jrsikken/AEMBLINK/AEMBLINK R2 PCB.jpg

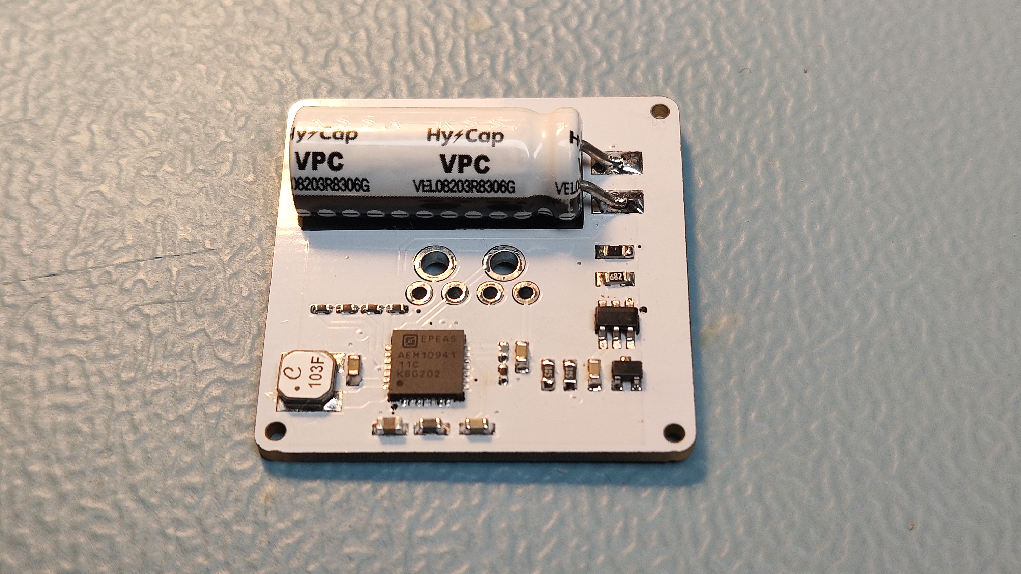
AEMBLINK R2 PCB.jpg
