jrsikken/AEMBLINK/AEMBLINK R2 in epoxy.jpg

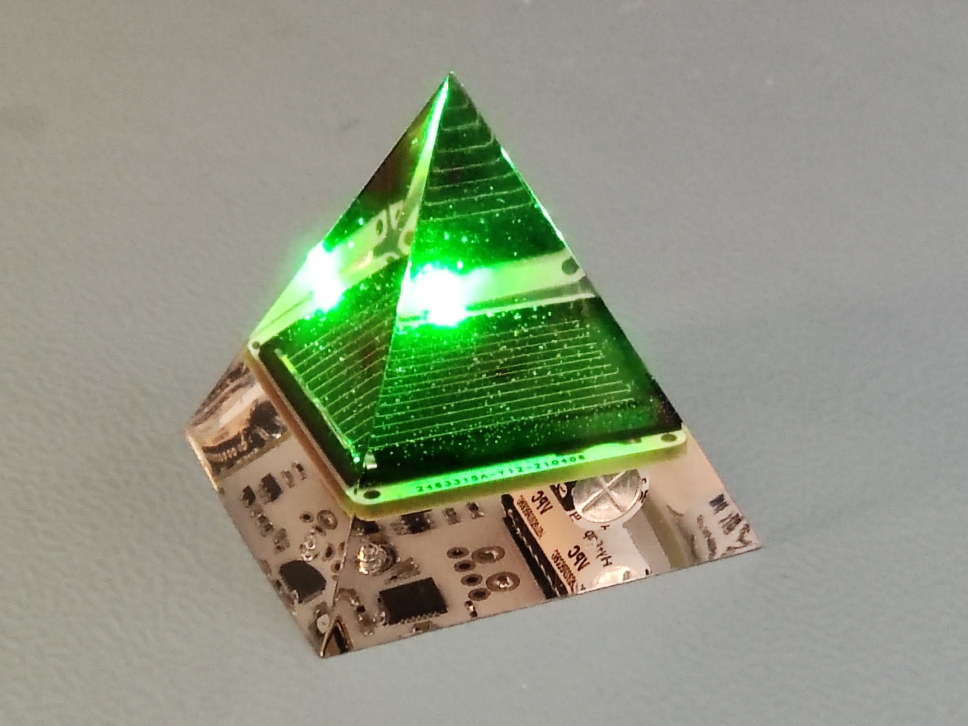
AEMBLINK R2 in epoxy.jpg
