jrsikken/AEMBLINK/README.md

# AEMBLINK
Design and production files for AEMBLINK, a solar harvesting LED blinking board

Eagle design files: *.sch and *.brd

Bill of Materials: *BOM.xlsx

Gerber files including stencil: *.gerber.zip

Schematic drawing: *SCHEMTAIC.png
