jrsikken/AEMBLINK/AEMBLINK-R1-SCHEMATIC.png

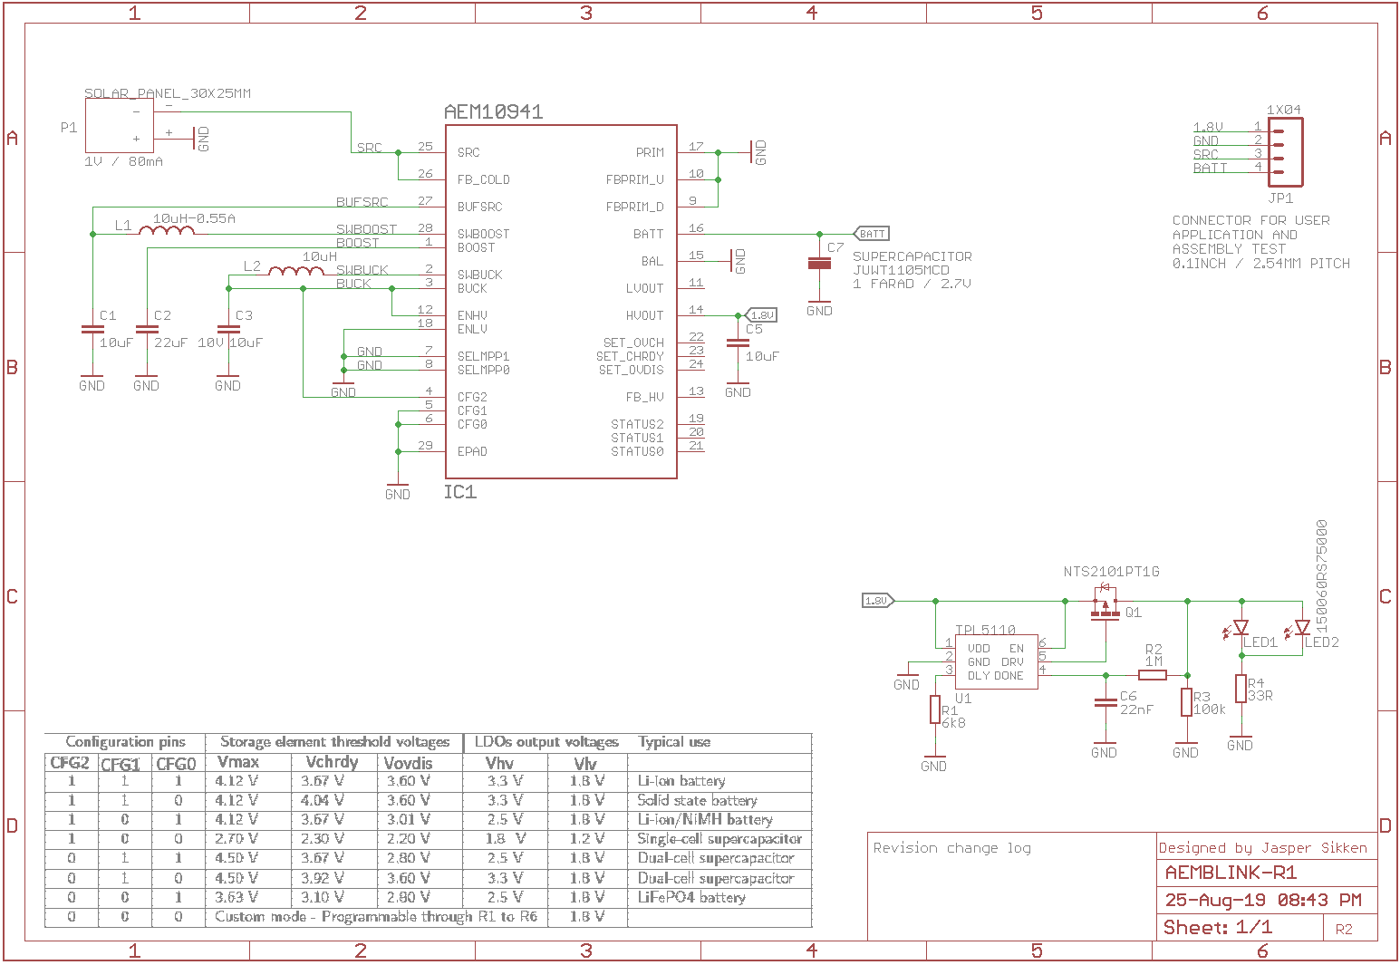
AEMBLINK-R1-SCHEMATIC.png
