jrsikken/AEMBLINK/AEMBLINK-R2-SCHEMATIC.png

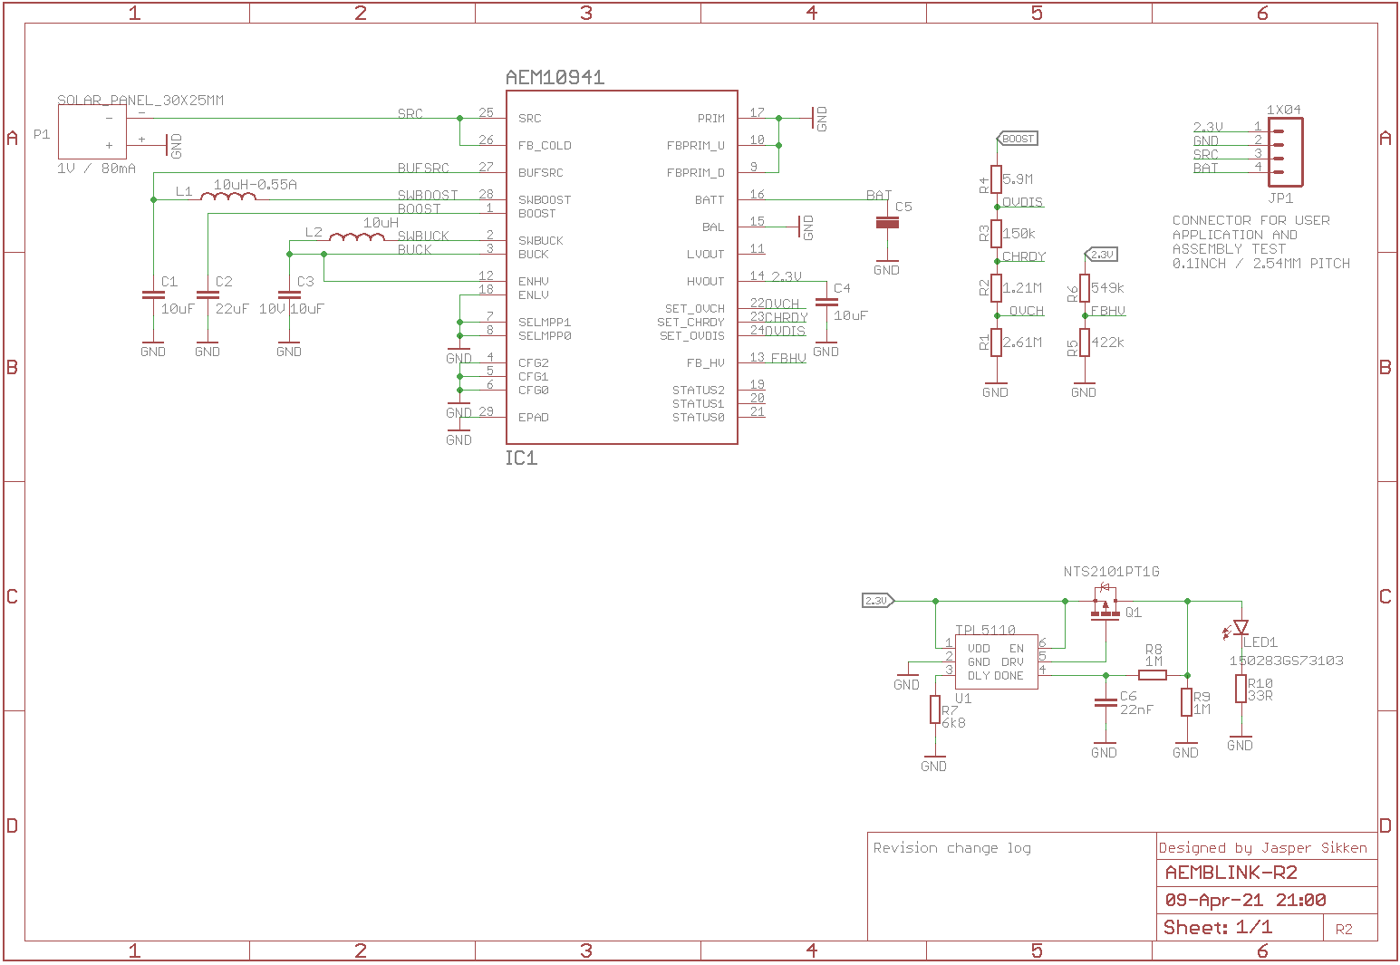
AEMBLINK-R2-SCHEMATIC.png
