jrsikken/AEMBLINK/AEMBLINK-R2-BOM.xlsx

# | reference designator | qty | value | package | Manufacturer | MPN | description | SMD | THT | PCB side | original | Voltage/Current | Dielectric | Tolerance
1 | C1,C3,C4 | 3 | 10uF | C0603 | Generic part | Generic part | capacitor | 6 |  | top | n | 10V | X5R | 0.2
2 | C2 | 1 | 22uF | C0603 | Generic part | Generic part | capacitor | 2 |  | top | n | 10V | X5R | 0.2
4 | C6 | 1 | 22nF | C0603 | Generic part | Generic part | capacitor | 2 |  | top | n | 25V | X7R | 0.1
5 | IC1 | 1 | AEM10941 | QFN50P505X50 | E-peas | AEM10941 | IC | 29 |  | top | y
6 | L1 | 1 | 10uH-0.55A | LPS4012 | COILCRAFT | LPS4012-103MRB | inductor | 2 |  | top | y
7 | L2 | 1 | 10uH-0.25A | L0603 | TDK | MLZ1608M100WT | inductor | 2 |  | top | y |  |  | 0.2
9 | Q1 | 2 | NTS2101PT1G | SOT323 | ON SEMICONDUCTOR | NTS2101PT1G | mosfet | 3 |  | top | y
10 | R1 | 1 | 2.61M | R0402 | Generic part | Generic part | resistor | 2 |  | top | n |  |  | 0.01
11 | R2 | 1 | 1.21M | R0402 | Generic part | Generic part | resistor | 2 |  | top | n |  |  | 0.01
12 | R3 | 1 | 150k | R0402 | Generic part | Generic part | resistor | 2 |  | top | n |  |  | 0.01
13 | R4 | 1 | 5.9M | R0402 | Generic part | Generic part | resistor | 2 |  | top | n |  |  | 0.01
14 | R5 | 1 | 422k | R0402 | Generic part | Generic part | resistor | 2 |  | top | n |  |  | 0.01
15 | R6 | 1 | 549k | R0402 | Generic part | Generic part | resistor | 2 |  | top | n |  |  | 0.01
16 | R7 | 1 | 6k8 | R0603 | Generic part | Generic part | resistor | 2 |  | top | n
17 | R8, R9 | 2 | 1M | R0603 | Generic part | Generic part | resistor | 4 |  | top | n
18 | R10 | 1 | 33R | R0603 | Generic part | Generic part | resistor | 2 |  | top | n
19 | U1 | 1 | TPL5110DDCT | SOT23-6 | TEXAS INSTRUMENTS | TPL5110DDCT | IC | 6 |  | top | y |  |  | 0.01
20 | LED1 | 1 | 150283GS73103 | D0603 | Wurth | 150283GS73103 | green LED | 2 |  | bottom | y
