jrsikken/AEMBLINK/AEMBLINK-R1.1-BOM.xlsx

Sheet: Bill of materials
reference designator | qty=1 | description | footprint | PCB side | original | value | Voltage/Current | Dielectric | Tolerance | Manufacturer | MPN
C1,C3,C5 | 3 | capacitor | C0603 | top | N | 10uF | 10V | X5R | 20% | Generic part | Generic part
C2 | 1 | capacitor | C0603 | top | N | 22uF | 10V | X5R | 5% | Generic part | Generic part
C6 | 1 | capacitor | C0603 | top | N | 22nF | 25V | X7R | 10% | Generic part | Generic part
IC1 | 1 | IC | QFN50P505X50 | top | SUPPLIED BY CUSTOMER | AEM10941 |  |  |  | E-peas | AEM10941
L1 | 1 | inductor | LPS4012 | top | SUPPLIED BY CUSTOMER | 10uH-0.55A |  |  |  | COILCRAFT | LPS4012-103MRB
L2 | 1 | inductor | L0603 | top | SUPPLIED BY CUSTOMER | 10uH-0.25A |  |  | 20% | TDK | MLZ1608M100WT
LED1, LED2 | 2 | LED red | D0603 | bottom | y | 150060RS75000 |  |  |  | Wurth | 150060RS75000
Q1 | 2 | mosfet | SOT323 | top | Y | NTS2101PT1G |  |  |  | ON SEMICONDUCTOR | NTS2101PT1G
R1 | 1 | resistor | R0603 | top | n | 6k8 |  |  |  | Generic part | Generic part
R2 | 1 | resistor | R0603 | top | n | 1M |  |  |  | Generic part | Generic part
R3 | 1 | resistor | R0603 | top |  | 100k |  |  |  | Generic part | Generic part
U1 | 1 | IC | SOT23-6 | top | y | TPL5110DDCT |  |  |  | TEXAS INSTRUMENTS | TPL5110DDCT
R4 | 1 | resistor | R0603 | top | n | 33R |  |  |  | Generic part | Generic part
C7 | 1 | super capacitor |  | top | y | JUWT1105MCD | 2.7V |  | 20% | Nichicon | JUWT1105MCD
P1 | 1 | solar panel |  |  | n | 1V 80mA 30x25mm | 1V |  |  | Generic part | Generic part

Sheet: Revision history
1.0 |  | Initial release
1.1 | 2019-08-30 | Changed R4 from 20R to 33R
