jrsikken/AEMBLINK/AEMBLINK-R2.brd

## EAGLE design AEMBLINK-R2.brd (2022-09-09)

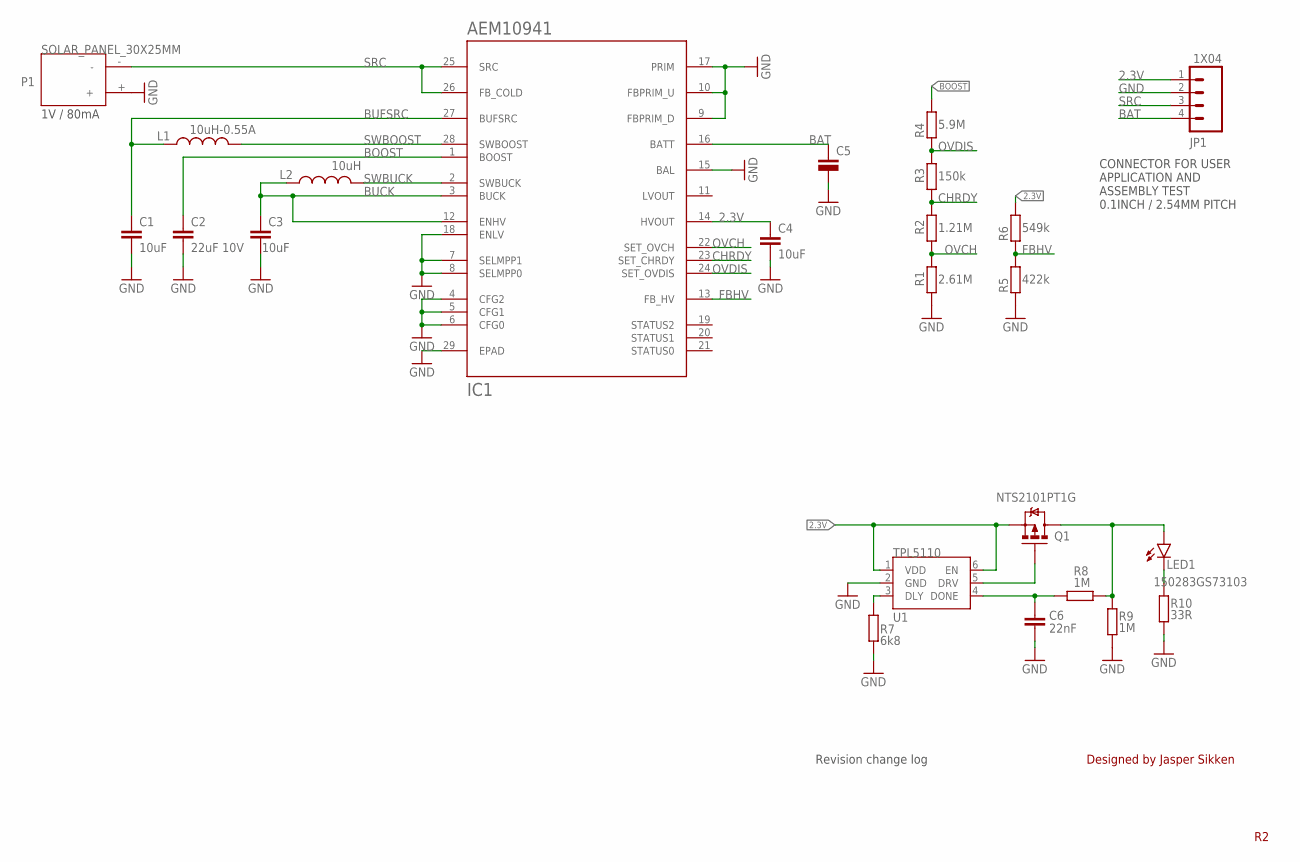
[picture p5: schematic AEMBLINK-R2.sch]

Parts:
C1, C3, C4: 10uF; C0603; MPN 1049P
C2: 22uF 10V; C0603; MPN CGA5L1X7S1A226M160AC
C5: SUPERCAPVEL08203R8306G; C_RADIAL_20L8D5P0.8H_HOR
C6: 22nF; C0603
IC1: AEM10941; QFN50P505X505X90-28
JP1: 1X04; 1X04_2.54MM_ROUND_NOSILK
L1: 10uH-0.55A; LPS4012; MPN SRN2009T-100M
L2: 10uH; L0603; MPN CK2125100M-T
LED1: 150283GS73103
P1: SOLAR_PANEL_30X25MM; SOLAR_PANEL_30X25
Q1: NTS2101PT1G; SOT323
R1: 2.61M; R0402
R2: 1.21M; R0402
R3: 150k; R0402
R4: 5.9M; R0402
R5: 422k; R0402
R6: 549k; R0402
R7: 6k8; R0603
R8, R9: 1M; R0603
R10: 33R; R0603
U1: TPL5110; SOT23-6

Connections:
2.3V: C4.1, IC1.14 (HVOUT), JP1.1, Q1.2 (S), R6.2, U1.1 (VDD), U1.6 (EN)
BAT: C5.+, IC1.16 (BATT), JP1.4
BOOST: C2.1, IC1.1 (BOOST), R4.2
BUCK: C3.1, IC1.3 (BUCK), IC1.12 (ENHV), L2.1
BUFSRC: C1.1, IC1.27 (BUFSRC), L1.1
CHRDY: IC1.23 (SET_CHRDY), R2.2, R3.1
DELAY: R7.2, U1.3 (DLY)
DONE: C6.1, R8.1, U1.4 (DONE)
DRIVE: Q1.1 (G), U1.5 (DRV)
FBHV: IC1.13 (FB_HV), R5.2, R6.1
GND: C1.2, C2.2, C3.2, C4.2, C5.-, C6.2, IC1.4 (CFG2), IC1.5 (CFG1), IC1.6 (CFG0), IC1.7 (SELMPP1), IC1.8 (SELMPP0), IC1.9 (FBPRIM_D), IC1.10 (FBPRIM_U), IC1.15 (BAL), IC1.17 (PRIM), IC1.18 (ENLV), IC1.29 (EPAD), JP1.2, P1.+, R1.1, R5.1, R7.1, R9.1, R10.2, U1.2 (GND)
LEDNET: LED1.2 (C), R10.1
unnamed: LED1.1 (A), Q1.3 (D), R8.2, R9.2
OVCH: IC1.22 (SET_OVCH), R1.2, R2.1
OVDIS: IC1.24 (SET_OVDIS), R3.2, R4.1
SRC: IC1.25 (SRC), IC1.26 (FB_COLD), JP1.3, P1.-
SWBOOST: IC1.28 (SWBOOST), L1.2
SWBUCK: IC1.2 (SWBUCK), L2.2

Notes on the sheet:
Designed by Jasper Sikken
Revision change log
CONNECTOR FOR USER APPLICATION AND ASSEMBLY TEST 0.1INCH / 2.54MM PITCH
1V / 80mA

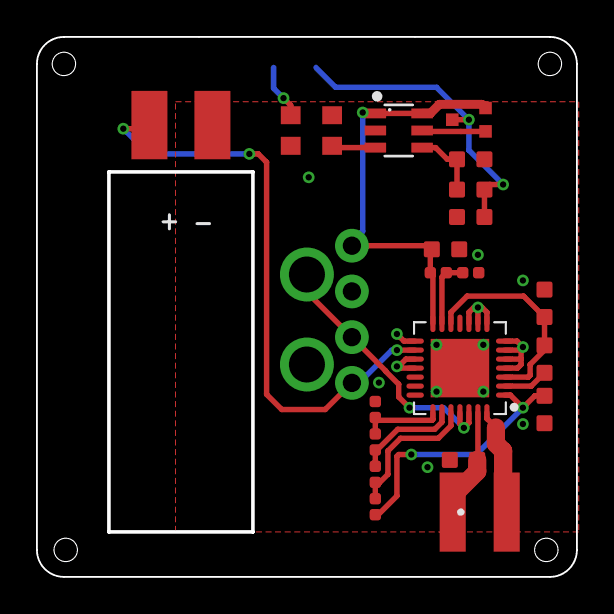
[picture p6: board AEMBLINK-R2.brd from above]

Board: 2 copper layers, 30.0 x 30.0 mm, 24 parts (1 on the bottom side), 18 nets.
