jrsikken/AEMBLINK/AEMBLINK-R1.brd

## EAGLE design AEMBLINK-R1.brd (2019-08-27)

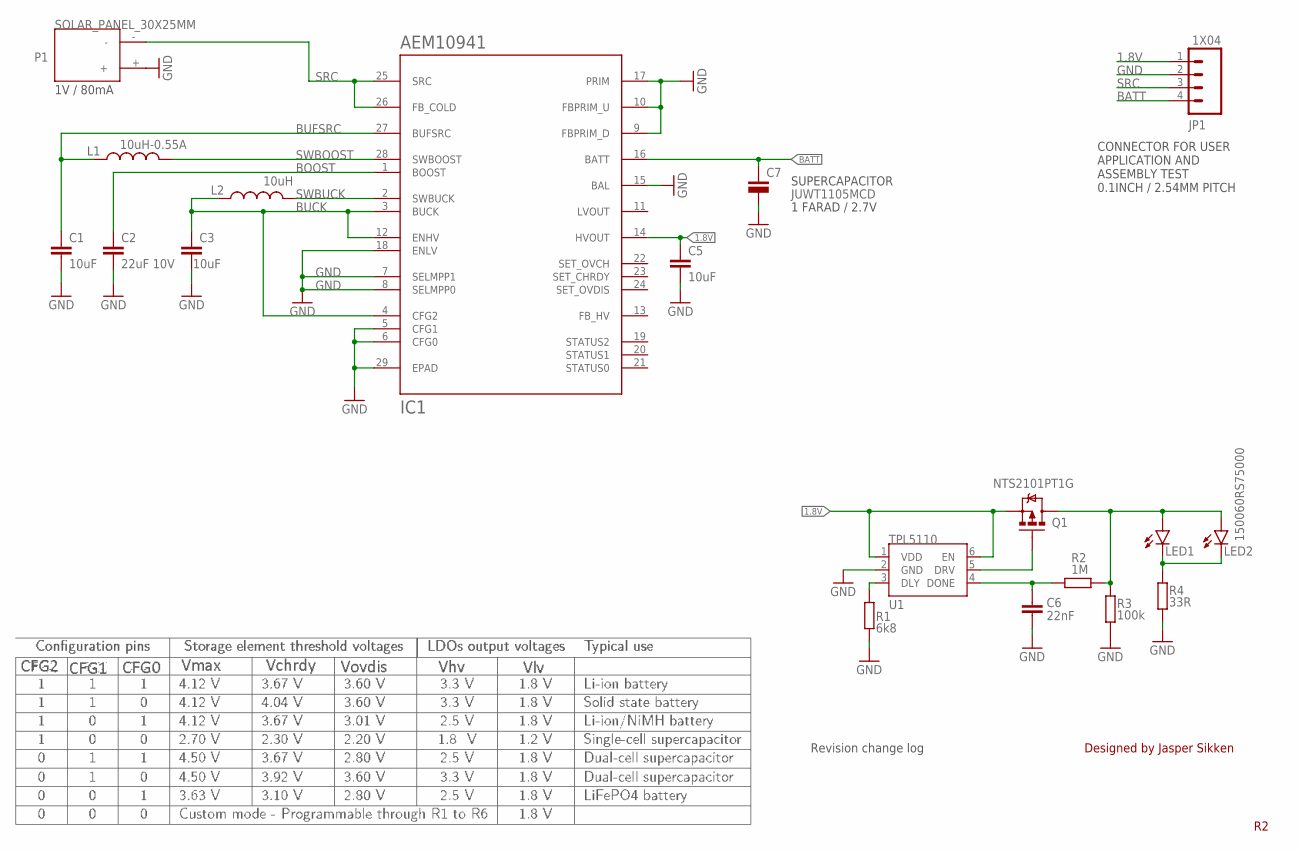
[picture p7: schematic AEMBLINK-R1.sch]

Parts:
C1, C3, C5: 10uF; C0603
C2: 22uF 10V; C0603
C6: 22nF; C0603
C7: JUWT1105MCD; C_RADIAL_9L6.3D2.5P0.5H_HOR
IC1: AEM10941; QFN50P505X505X90-28
JP1: 1X04; 1X04_2.54MM_ROUND_NOSILK
L1: 10uH-0.55A; LPS4012
L2: 10uH; L0603
LED1: LEDCHIPLED_0603; CHIPLED_0603
LED2: 150060RS75000; CHIPLED_0603
P1: SOLAR_PANEL_30X25MM; SOLAR_PANEL_30X25
Q1: NTS2101PT1G; SOT323
R1: 6k8; R0603
R2: 1M; R0603
R3: 100k; R0603
R4: 33R; R0603
U1: TPL5110; SOT23-6

Connections:
1.8V: C5.1, IC1.14 (HVOUT), JP1.1, Q1.2 (S), U1.1 (VDD), U1.6 (EN)
BATT: C7.+, IC1.16 (BATT), JP1.4
BOOST: C2.1, IC1.1 (BOOST)
BUCK: C3.1, IC1.3 (BUCK), IC1.4 (CFG2), IC1.12 (ENHV), L2.1
BUFSRC: C1.1, IC1.27 (BUFSRC), L1.1
DELAY: R1.2, U1.3 (DLY)
DONE: C6.1, R2.1, U1.4 (DONE)
DRIVE: Q1.1 (G), U1.5 (DRV)
GND: C1.2, C2.2, C3.2, C5.2, C6.2, C7.-, IC1.5 (CFG1), IC1.6 (CFG0), IC1.7 (SELMPP1), IC1.8 (SELMPP0), IC1.9 (FBPRIM_D), IC1.10 (FBPRIM_U), IC1.15 (BAL), IC1.17 (PRIM), IC1.18 (ENLV), IC1.29 (EPAD), JP1.2, P1.+, R1.1, R3.1, R4.2, U1.2 (GND)
LEDNET: LED1.C, LED2.C, R4.1
unnamed: LED1.A, LED2.A, Q1.3 (D), R2.2, R3.2
SRC: IC1.25 (SRC), IC1.26 (FB_COLD), JP1.3, P1.-
SWBOOST: IC1.28 (SWBOOST), L1.2
SWBUCK: IC1.2 (SWBUCK), L2.2

Notes on the sheet:
Designed by Jasper Sikken
Revision change log
SUPERCAPACITOR
1 FARAD / 2.7V
CONNECTOR FOR USER APPLICATION AND ASSEMBLY TEST 0.1INCH / 2.54MM PITCH
1V / 80mA

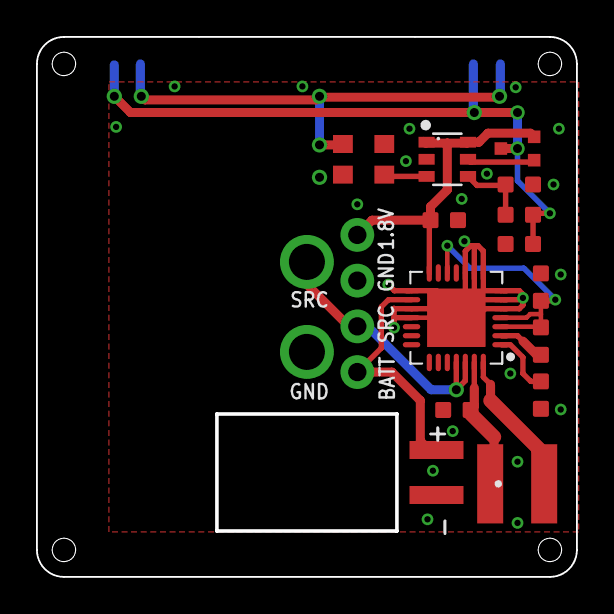
[picture p8: board AEMBLINK-R1.brd from above]

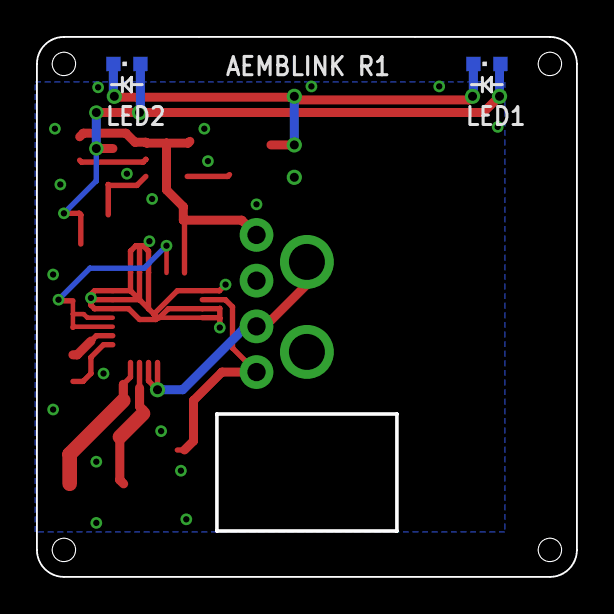
[picture p9: board AEMBLINK-R1.brd from below]

Board: 2 copper layers, 30.0 x 30.0 mm, 19 parts (2 on the bottom side), 14 nets.
