jrsikken/AEMBLINK/(commit log)

2019-08-27 First release
    [AEMBLINK-R1-BOM.xlsx, AEMBLINK-R1.brd, AEMBLINK-R1.sch]
2019-08-30 changed R4 from 27R to 33 ohm
    [AEMBLINK-R1-BOM.xlsx, AEMBLINK-R1.1-BOM.xlsx]
2019-08-30 added solar panel and super capacitor
    [AEMBLINK-R1.1-BOM.xlsx]
2019-10-01 add gerber files
2022-09-09 added all R2 files
    [AEMBLINK-R2-BOM.xlsx, AEMBLINK-R2.brd, AEMBLINK-R2.sch]
